smford/maslow-cnc-halo/support_v3.dxf

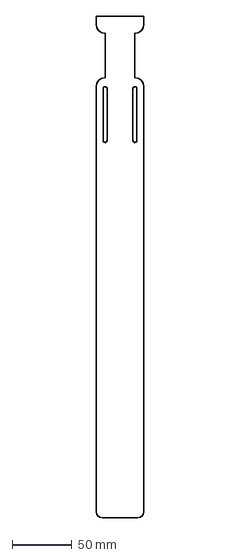
[picture p6: CAD file, 2021-03-05]
support_v3.dxf
40.0 x 421.0 mm
