smford/maslow-cnc-halo/ring_v3.dxf

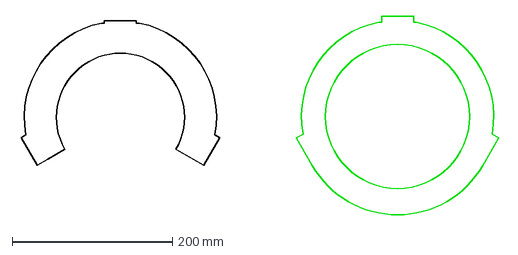
[picture p7: CAD file, 2021-03-05]
ring_v3.dxf
606.0 x 247.9 mm
