smford/maslow-cnc-halo/support_v2.dxf

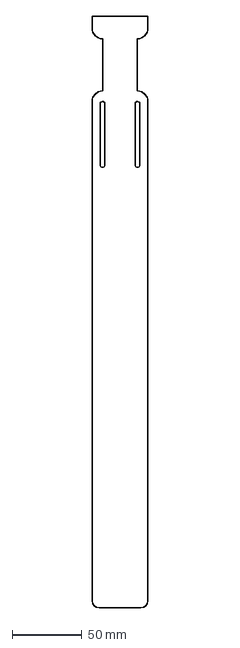
[picture p8: CAD file, 2021-03-05, an earlier design]
support_v2.dxf
40.0 x 423.0 mm
